tylerclindsay/volu_disp/docs/generators.md

# Generators

Status: **working draft.** Design of `volu_gen/generators/`, replacing open
question 1 in `architecture.md`. Values marked *(tune)* are starting
points to check by eye once methods exist; questions still open are
collected at the end.

Related: `architecture.md` (render job, storage), `ui.md` (Studio),
`decisions/0004-audio-analysis.md` (`analysis.json`),
`decisions/0010-display-fps.md`, `decisions/0011-planning-in-server.md`.

---

## Concept
The generator is a **director** that runs a set of **methods**. A method
is one way of animating the display from the music: rain, fireworks,
geometry, a 3D spectrogram, and so on. The director splits the track into
**segments** and picks a method (and that method's parameters) for each,
based on what the analysis knows about that part of the song. Calm parts
change rarely; high-energy parts change faster, per few bars or per bar.

Rendering is two steps:
1. **Plan.** The director reads the music data and writes a **plan**: a
   list of segments, each with a time range, a method, the method's
   params, and how it transitions in. The plan is plain data (JSON).
2. **Render.** Each segment's method renders its frames; the job blends
   transitions, applies intensity, quantizes, and writes the animation file.

```mermaid
flowchart LR
    AJ["analysis.json"]
    FT["features.npz"]
    AU["source + stems<br/>(samples)"]
    M["Music<br/>(queries over time)"]
    DP["track params<br/>(Studio)"]
    OV["instance edits<br/>(Studio, pinned)"]
    DIR["Director"]
    PLAN["Plan<br/>segments · methods · params"]
    METH["Methods"]
    OUT["blend transitions →<br/>intensity → uint8"]
    ANIM[".anim"]

    AJ --> M
    FT --> M
    AU --> M
    M --> DIR
    DP --> DIR
    OV --> DIR
    DIR --> PLAN
    PLAN --> METH
    M --> METH
    METH --> OUT --> ANIM
```

Splitting plan from render is what makes editing possible. In v1 the user
edits the params of each **instance** of a method (each segment it runs
in) in Studio; the future manual editor also changes which method runs on
which beats, bars, or sections. Either way the edits are plan entries the
director keeps, so it never has to understand them.

## Methods
Each method declares what it suits (phrase types, energy range) so the
director can choose it, and **chooses its own base params** from the
segment it's given (BPM, energy, mood, phrase type). Kicks and bass should
drive most of them visibly.

| Method | Idea | Driven by (examples) |
|---|---|---|
| `spectrogram` | 3D spectrogram: frequency across x, amplitude as height, history scrolling back through the slices (z) | band spectrum; kick → flash of the newest slice |
| `raindrops` | A "sea" surface of pixels at some height; drops land and spread ripples | hats spawn drops; kick → big drop; bass → swell height |
| `rain` | Falling streaks | density from energy; kick → gust or flash |
| `fireworks` | Launches, bursts into expanding shells that fall under gravity | accents (phrases, bars) launch; kick → burst; drops → volley |
| `strobe` | Full display or alternating slices, on beats or subdivisions | beat grid; drops only by default (see Smoothness) |
| `static` | TV-style noise, colorful or black and white | bass → density / brightness |
| `geometry` | Basic shapes (cube, sphere, torus, …) spinning smoothly and moving around | kick → scale pulse; bass → glow |
| `galaxy` | Individual pixels as stars; slow rotation, spiral arms, twinkle | energy → rotation speed; kick → brightening |
| `landscape` | Procedural mountain range scrolling through the display, as if flying over land | energy → speed; bass → terrain pulse |
| `supernova` | Spinning explosion from the center, expanding shell and debris | drop → explosion; kick → shockwaves |
| `oscilloscope` | A stem's waveform drawn as a line. 2D: in one slice, or copied to every slice. 3D: each slice holds an older frame's waveform, so the waveform scrolls back through the volume as a surface. Variant: one stem per group of slices | samples of a chosen stem; kick → line brightness / thickness |
| `vectorscope` | Stereo shapes: left vs. right channel as x / y (rotated 45° to mid/side, as a goniometer does), with a trail receding through the slices. 3D variant: delay embedding, `(s(t), s(t−τ), s(t−2τ))`, gives Lissajous-like 3D shapes even from mono stems | samples of a chosen stem; stereo width → shape size; kick → flash |
| `model` *(deferred)* | Plays a hand-made 3D animation file, set manually | needs an import format (e.g. glTF) and voxelization |

Interface:

```python
class Method(Protocol):
    id: ClassVar[str]                     # stable, e.g. "raindrops"
    version: ClassVar[int]                # bump when output changes for the same params
    Params: ClassVar[type[BaseModel]]     # per instance (segment); pydantic → JSON Schema
    suits: ClassVar[Suitability]          # phrase types, energy range, shortest segment (bars)

    @classmethod
    def choose_params(cls, seg: SegmentInfo, music: Music, rng) -> Params: ...

    def __init__(self, ctx: RenderContext, seg: SegmentInfo, params: Params): ...
    def render(self, start: int, stop: int) -> np.ndarray: ...   # float32 [n, P, 3]
```

- `render` works on **any frame range within the segment** (a little
  beyond it too, for transitions), vectorized over frames and pixels.
- `__init__` may precompute **cheap per-segment data**: particle spawn
  lists (time, position, size), the landscape's travelled distance (the
  integral of its speed over time), a star field. Each frame is then a
  closed-form function of time and that data, e.g. a ripple's radius is
  a function of time since its drop landed.
- No state carried frame to frame. This keeps segments independent: a
  transition can render two methods over the same frames, the manual
  editor can re-render one segment, and the deferred loop preview works.
  It rules out true simulations (fluids, reaction-diffusion); none of the
  methods above need one.
- Methods that read audio samples read only the requested range plus a
  declared look-back (e.g. the 3D oscilloscope's slice history), so they
  stay range-independent too.

**Waveform methods and smoothness.** Raw waveforms jitter and alias on a
sparse display, so `oscilloscope` and `vectorscope`:
- **trigger** like a real oscilloscope: align each frame's window to a
  rising zero crossing (or the pitch period), so a steady tone holds still
  instead of jumping between frames;
- **low-pass and resample** the window to the display's resolution before
  drawing (the prototype is 10 pixels wide: only ~10 points of waveform
  are visible), and draw the line with the usual soft falloff;
- **blend over a few frames** (short persistence, like phosphor), which
  also gives the vectorscope its trail.

Bass and kick stems are often near-mono, which collapses a left/right
vectorscope to a line; the director should prefer stems with stereo width
(a feature, below) or the delay-embedding variant.

**As built** (`methods/`, one module each, registered on import;
`decisions/0019-first-methods.md`). All four draw in `ctx.box` with soft
edges `ctx.pitch` wide, and share `methods/common.py`: `soft`,
`hit_env` (kick decays), `Signal.envelope` (a smoothed lane envelope over
the segment's span) and `Signal.integral` (speed → angle). Values are
starting points *(tune)*:
- `geometry` (class `Shapes`): `shapes` from sphere (shell), cube (edges),
  octahedron (shell), torus (tube) and rings (three at right angles). The
  shape turns `spin` times per bar about y plus a tumble axis, drifts on a
  Lissajous path (`wander`), pulses in scale on kicks (`pulse`, 0.12 s
  decay) and gets a bass halo (`glow`). With `swap_beats`, the next shape
  morphs in (the two distances blended) over `morph` beats, ending on the
  swap beat. Suits any phrase, −20 to +6 dB; drops get 2–3 shapes swapping
  every 1–2 beats, loud parts every 4 beats, quieter parts one shape.
- `raindrops`: a sea surface at `level`, raised by the bass (`swell`) and
  slow background waves, with dim water under it (`fill`). Drops land on a
  share of hats (`hats`), big drops on kicks of strength ≥ 0.5, and
  `ambient` drops per second at random times so calm parts still rain.
  The drop list is made once per segment; a drop falls under gravity for
  0.35 s, then a ring spreads at `speed` and fades (0.45 s), lifting and
  lighting the surface. Suits groove, breakdown and buildup, −30 to −2 dB,
  at least 2 bars.
- `strobe`: flashes `per_beat` times per beat from bar 1, `duty` of the
  period but at least one frame, halved until within `ctx.strobe_rate`.
  `pattern`: `all`, `slices` (odd and even slices take turns) or `chase`
  (one slice per flash, front to back). Color toward white by `white`;
  brightness follows the drums by `follow`. Suits drops only, −6 to +6 dB.
- `galaxy`: a disc tilted by `tilt` and `yaw` with `arms` logarithmic
  spiral arms (`twist`), a bulge and a core. The arms turn rigidly at a
  speed that follows the mix's energy (a third of `spin` when quiet).
  Each pixel is a star: a share (`stars`) bright, the rest dust, each
  twinkling at its own rate (`twinkle`). Kicks brighten it (`kick`, 0.25 s
  decay). Suits groove, breakdown and buildup, −40 to −4 dB, at least
  4 bars.

## Director
**Segmenting:**
- Start from the analysis phrases (8 bars from each section start and
  drop). Split further by energy: low energy keeps a method for a whole
  phrase or section; medium switches every 4 bars; high energy (drops)
  every 2 bars or every bar *(tune)*. Boundaries always land on the grid.
- **Per-beat changes happen inside a method**, not by switching methods
  (e.g. strobe alternating slices each beat, geometry swapping shapes on
  the beat). Per bar is the fastest the director switches methods.
- Variable-tempo tracks (no grid): segment by sections, use raw beats.

**Choosing a method** for a segment:
- Inputs: phrase type, energy (per-bar mix energy, drums/bass on or off),
  mood, genre, position in the track, and what came before.
- Each method's `suits` gives it a score for the segment; the director
  picks by weighted random choice with a per-segment seed, and avoids
  repeating the previous segment's method.
- **Repeated parts pick freely.** A second drop gets no special link to the
  first; it is scored and chosen like any other segment.
- A **track palette** is chosen once from mood and genre and passed to
  every method, so method changes stay visually coherent.

**Phrase types.** The director uses the analysis as it is: `drop`,
`buildup`, `breakdown` tags, untagged phrases (the track's "groove"),
drums/bass events, and per-bar energy. No intro/outro tags are added;
those parts already read as low energy, drums or bass off, at the start or
end of the track.

**Transitions.** Chosen from how different two neighboring segments really
are, not one fixed rule:
- **Into a drop: always a hard cut** on the downbeat.
- Otherwise the director scores the **contrast** between the two segments
  from these inputs (weights: open question 1): the energy jump (dB, per-bar mix energy), drums or
  bass switching on/off, a section boundary vs. a split inside a phrase,
  and a change of phrase tag.
- High contrast → a hard cut on the downbeat. Medium → a 1–2 beat
  crossfade (the baseline). Low (e.g. a split inside one phrase, same
  material) → a longer crossfade, up to a bar.
- The transition is part of each plan entry, so the editor can change it.

**As built** (`director.py`, `make_plan` / `replan`; constants marked
*(tune)* there):
- **Units:** phrase starts (variable tempo: section starts and drops),
  from bar 1 to one past the last downbeat. Each unit gets a **level**:
  `high` = a drop phrase; `low` = a breakdown (not also a buildup) or mean
  mix energy under −10 dB; else `medium`. `high` is drops only: most of an
  electronic track sits near its loud level (median bar ≈ −4 dB across the
  library), and switching every 2 bars through all of it was frantic.
- A unit under 2 bars (a section's short tail) joins the one before and
  takes its level; a short first unit joins the next; a drop never moves.
- **Segment length** per level at change rate 1: low 16 bars, medium 4,
  high 2 *(tune)*; divided by the change rate and rounded to a power of
  two, 1 to 64 bars. Consecutive units of one level in one section merge
  up to that length (so a calm intro and breakdown share one segment), and
  each run is cut into segments of it; a remainder of up to half a segment
  joins the last one. Never merged across a drop.
- **Score** = track-param weight × fit: 0 if the segment's tags miss the
  method's phrase types or it is shorter than `min_bars`, else
  `exp(−(d / 6 dB)²)` for the energy `d` outside its range. One uniform
  draw from the segment's plan RNG picks by weight, then the same RNG goes
  to `choose_params`. The previous segment's method scores 0 unless
  nothing else fits; if nothing fits at all, the weights alone choose.
  Mood, genre and position in the track don't enter the score yet.
- **Contrast** at a boundary bar: `|ΔdB| / 6` (mix, 2 bars either side,
  capped at 1) + 0.5 per drums/bass in/out within a bar (capped at 1) +
  0.5 for a section start or 0.25 for a phrase start + 0.5 if the tags
  change. ≥ 1 → cut; ≥ 0.5 → 1-beat crossfade; ≥ 0.25 → 2 beats; under →
  one bar. A crossfade is at most a quarter of either segment.
- **Pinned** segments (a previous plan's, passed to `make_plan`) are cut
  into the automatic segments, clipped to the track; pins outside it or
  of an unregistered method are dropped, override fields the method no
  longer has are dropped, and a bad override value fails planning. A
  pinned segment draws from its RNG like an automatic one, so pinning
  doesn't change its automatic params.
- **Palette:** named palettes in `palette.py`, each with three mood words;
  auto picks by weighted random choice (track seed, `TRACK_STREAM`), weight
  `exp(2 × mean z)` of its words. The server should pass library-wide mood
  z-scores (decision 0004); without them the track's own cosines are
  standardized across its words, which removes the track's overall level
  but not each word's bias. Genre isn't used yet. Plans store sRGB hex;
  `RenderContext.colors` gives methods linear RGB.

## Plan
```jsonc
{
  "director": { "version": 1, "params": { … } },        // track params
  "palette": [ … ],
  "segments": [
    { "start_bar": 1, "end_bar": 17, "start": 0.889, "end": 24.889,
      "method": "raindrops", "method_version": 1,
      "params": { "drop_size": 0.4, … },     // what choose_params picked
      "transition": { "kind": "cut" } },
    { "start_bar": 49, "end_bar": 57, …,
      "method": "raindrops",
      "params": { "drop_size": 0.4, … },
      "overrides": { "drop_size": 0.9 },     // user edit: this instance only
      "pinned": true,
      "transition": { "kind": "crossfade", "beats": 1 } }
  ]
}
```
- Deterministic: same analysis + features + track params + edits + seed +
  versions → same plan.
- **Instance edits** (v1): `overrides` holds only the fields the user
  changed; every other field stays automatic. A segment with overrides is
  **pinned**: re-planning (new track params or seed, a grid override, a
  generator or method version change) keeps its bars, method, and
  overrides, and plans the rest around it.
  Its automatic fields are re-chosen as usual.
- Segments are anchored by **bar numbers**, so they survive a grid
  override; `start`/`end` are recomputed from the current grid before
  every render, so a stored plan never renders on an old grid. Segments
  are contiguous; the first also covers any lead-in before its bar (it may
  start at bar 0) and the last runs to the end of the track.
- **Planning runs in the API server**, not as a worker job
  (`decisions/0011-planning-in-server.md`): it is pure Python over
  `analysis.json` and `features.npz` (milliseconds, no models), so Studio
  shows the new plan as soon as a track param or instance changes, without
  waiting behind analysis jobs. The render job is given the plan and
  renders exactly it. The version's DB row stores the track params and the
  plan; the `.anim` metadata carries a copy (`plan` key).
- Consequence: everything planning touches (the director, `Music`, each
  method's `Params` and `choose_params`) is imported by the server, so
  `generators/` keeps heavy imports (torch) out of module level.
- **Plans don't depend on the FPS.** Segments are in bars and seconds;
  the display FPS only enters at render time (including strobe's
  half-FPS limit, Smoothness), so an FPS re-render renders the stored
  plan unchanged (decision 0010). A render re-plans first only if the
  version has no plan yet or the generator or a method version changed;
  the new plan overwrites the stored one.
- **Manual editor (deferred):** also change a segment's method,
  boundaries, and transition; those edits pin the segment the same way.

## Studio parameters (v1)
Two levels:

**Track params** — the director's, constant for the whole track
(`DirectorParams`: `intensity`, `change_rate`, `palette`, `weights`,
`disabled`, `strobe_max_rate`, `seed`; intensity and the strobe rate don't
affect the plan and are applied at render):
- overall intensity / brightness
- change rate (how quickly segments switch, relative to the default)
- palette: from the track, or a user pick
- methods: which are enabled, and a weight for each (how often the
  director picks it)
- strobe max flash rate (default and ceiling: 60 flashes/s, or half the
  FPS if lower)
- seed (re-roll for a different plan)

**Instance params** — per use of a method. If `raindrops` runs in bars
1–17 and again in bars 49–57, each has its own drop size:
- Studio shows the plan as a **segment lane** above the stem lanes; each
  block is one instance, labeled with its method.
- Selecting a block opens that method's `Params` form, filled with the
  values `choose_params` picked. Changing a field overrides it for that
  instance only and pins the segment (Plan, above); changed fields are
  marked, and "reset" returns a field (or the whole instance) to
  automatic.
- The form is generated from the method's `Params` schema, so adding a
  param needs no UI code.

Presets save track params only. Instance edits belong to one track's plan
and are saved with its versions.

## Smoothness
Motion smoothness is a priority. The display is sparse (50 mm pitch), so
things must glide between pixels instead of popping:
- **Spatial:** never switch a pixel hard on/off at a shape's edge. Render
  every shape as a distance with a soft falloff about one pixel pitch
  wide, so a moving edge fades across pixels.
- **Temporal:** everything is a continuous function of time in seconds
  (not the frame index). Param changes ease in; envelopes have attack and
  release.
- **Hits:** a kick is a near-instant attack with a smooth decay
  (~100–300 ms): punchy without flicker.
- **Exceptions:** `static`, `strobe`, and star twinkle flicker on purpose.
  Strobe's max flash rate is **60 flashes/s**, or half the render's FPS
  if that is lower (one on/off cycle per two frames: 15 flashes/s at
  30 FPS, 60 from 120 FPS up); the track param can lower it. The plan
  holds the requested rate; the half-FPS limit is applied at render time,
  so the plan stays independent of the FPS. Faster
  flashing fuses into steady half brightness, so a strobe looks the same
  at any rate from 120 FPS up. A render always plays at its own FPS
  (decision 0010), so frames are never dropped and a strobe never
  aliases.

## Inputs
**`Music`** — built once per render from `analysis.json`,
`features.npz`, and the audio; vectorized queries over an array of times:
beat and bar index and phase, the current section and phrase and its tags,
time since and until events, per-bar energy (interpolated), feature
envelopes, genre, mood, palette. It hides grid vs. variable tempo and the
user override. The raw `analysis.json` dict is available as an escape
hatch. The API server also builds a `Music` for planning; it never
touches audio there (the server doesn't read audio), so audio is
decoded lazily, only when a method in the worker asks for samples.

**Audio samples** — methods can read the actual waveforms:
- `music.samples(stem, t0, t1)` → `[n, 2]` float32 stereo at 44.1 kHz,
  for `vocals`, `drums`, `bass`, `other` (`stems/*.flac`) or `mix`
  (`source.<ext>`).
- `music.windows(stem, ctx.times(start, stop), length)` →
  `[frames, length, 2]`: the window of samples ending at each frame's
  time, the common case for waveform methods (a frame spans
  ~1,470 / ~367 / ~92 samples at 30 / 120 / 480 FPS).
- Decoded once per render and cached in the render job: four stereo stems
  of a 4-min track are ~340 MB as float32, fine for the worker; decode per
  chunk if the large build makes this tight.
- Offline only: playback still reads just the animation file.

**`features.npz`** — needed from the start, since kicks and bass drive most
methods. A new CPU stage `features` in analysis (full spec in
`decisions/0012-stem-features.md`):
- onsets with strength: `kick` and `hat` only, recognized on the drums
  stem by a drum transcription model
  (`decisions/0016-drum-onsets-adtof.md`); the other drum classes and the
  `bass` / `other` / `vocals` onsets were not reliable and are not stored
  (`decisions/0017-kick-and-hat-onsets-only.md`)
- envelopes per lane (mix + four stems, RMS, 300 Hz), unsmoothed, with
  each lane's loud level so `Music` can normalize them
- a 24-band log-frequency spectrum (40 Hz – 16 kHz, 100 Hz) **per stem
  and for the mix**, for `spectrogram` and for coloring by what a stem is
  doing
- stereo width per lane (100 Hz), so the director can choose
  `vectorscope` and its stem
- fixed rates, independent of the display FPS and the grid, so neither an
  FPS change nor a grid override re-runs this stage; `Music` interpolates
  envelopes and spectra to frame times, and onsets are stored as times, so
  a hit shows from the first frame starting at or after it, at any rate
- Methods use features where they can (cheap, precomputed) and raw
  samples where they need the waveform's shape.

**`RenderContext`** — pixel positions, fps (the display FPS when the
render started: any whole number from 30 to 480), frame count, `Music`,
seed. Methods work in seconds, never assume a frame rate, and look the
same at any rate:
- `pos`: normalized, centered, **y up** (rain and fireworks fall, the
  landscape has a ground), divided by the largest half-extent so aspect
  ratio is kept: a method written for the prototype fits the large build
- `box`: the same positions with each axis stretched to [-1, 1] (y up),
  so a shape fills the volume whatever its aspect, and `pitch`, the
  nearest-neighbour spacing in it (soft edges are about this wide); the
  first methods draw in `box` (`decisions/0019-first-methods.md`)
- also `pos_mm` and integer `(ix, iy, iz)` per pixel plus slice parity, for
  methods that address slices or strips (alternating-slice strobe)
- `times(start, stop)`: each frame's start, `k / fps`. The engine shows
  frame `floor(t × fps)` (`architecture.md` → Engine), so frame k is on
  screen from that time; a hit inside a frame first shows on the next one
  (under one frame late: ≤ 8 ms at 120 FPS), a constant the A/V offset
  calibration absorbs.
- frame count `ceil(duration × fps)`.
- `strobe_rate`: the fastest a method may flash, flashes/s: the track's
  `strobe_max_rate`, at most 60 and half the FPS (Smoothness).

Built: `volu_gen/generators/` → `music.py`, `context.py`, `method.py`
(interface, `SegmentInfo`, `Suitability`, registry, `segment_rng`),
`plan.py` (pydantic plan model), `director.py`, `palette.py`,
`render.py` (the render job) and `methods/`; tests in
`tests/test_generators.py`, `tests/test_director.py`,
`tests/test_render.py` and `tests/test_methods.py`.

## Output and render job
- Methods return float32 linear RGB `[0, 1]`. The job blends transitions,
  scales by the track's intensity, clips, and quantizes to uint8 for the
  file. No gamma curve: the file holds WS2811 PWM values, which are
  linear in light like the methods' output
  (`decisions/0018-render-output.md`).
- Global brightness is applied at playback by the engine (adjustable
  live, like the sync offset). There is no power cap
  (`decisions/0020-brightness-no-power-cap.md`).
- The job renders in animation-file chunks (1 s: `fps` frames), in order, and
  checks for cancel between chunks. A chunk that straddles a segment
  boundary asks both methods for their part.
- Randomness: a per-segment RNG seeded from `(seed, segment start bar)`,
  so re-planning or editing one segment doesn't reshuffle the others.
  Planning (`choose_params`) and rendering (`Method.rng`) draw from
  separate streams of it (`segment_rng`).
- Versions (integers): the generator version covers the director; each plan entry
  records its method version. A render is stale if either changed (or the
  geometry hash or file format version; `architecture.md` → Lifecycle),
  and re-rendering it after a version change re-plans first.
- numpy on the CPU first; allow torch inside a method if a 20k-pixel render
  measures too slow. Methods are registered in a dict keyed by `id`.

**As built** (`render.py`; decision 0018):
- `render_context(geometry, music, fps, plan)` builds the context from the
  plan's seed, palette and strobe limit. `Renderer(ctx, plan)` retimes
  the plan on the current grid and refuses a stale one (`StalePlan`:
  another director version, a changed or unregistered method), and
  validates every segment's params and overrides, before rendering a
  frame. The server re-plans; the job renders exactly what it's given.
- **Crossfades are centered on the downbeat**: `beats × beat length`,
  half before and half after, smoothstep weights, each half at most half
  the segment on its side so fades never overlap. A segment's weight is
  `ramp(t, start, h_in) − ramp(t, end, h_out)`, so each frame's weights sum
  to 1; a cut is a step (a frame starting on the downbeat is the new
  segment's). Blended in linear light.
- Each segment's method renders only the frames where its weight is
  above 0. Rendering any frame range gives the same frames, so the chunk
  size never changes the output (tested at 1, 7, 97 and 500 frames).
- A method is built at its first frame and dropped after its last, so
  memory stays flat. Its `SegmentInfo` carries the plan's retimed
  `start`/`end` (the first segment from 0 s, covering the lead-in; the
  last to the end of the track).
- Method output must be float32 `(n, P, 3)` and finite; anything else fails
  the render, naming the method and frame range.
- `render_anim(path, ctx, plan, render_id, progress=, cancelled=)` writes
  the `.anim` (`.tmp`, renamed when done) in 1 s chunks with the metadata
  of decision 0008 (generator id `director`), calls `progress` and checks
  `cancelled` between chunks; a cancel raises `RenderCancelled` and leaves
  no file.
- Overhead of the job alone (blend, quantize, zstd) at 20k pixels: about
  80 ms per second of track at 120 FPS, 320 ms at 480 FPS (dev PC, one
  trivial method); methods will dominate.

## Build order
1. The `features` analysis stage.
2. `Music`, `RenderContext`, the director, the plan, and the render job.
   *Built:* `Music`, `RenderContext`, the method interface and
   registry, the plan model, the director, and the render job (the worker
   process runs it: `worker/`). The director's lengths,
   levels and contrast weights are tuned by eye once the first methods
   exist.
3. First methods: `geometry`, `raindrops`, `strobe`, `galaxy` (they cover
   calm through drop). *Built* (decision 0019); their looks and the
   director's constants are tuned by eye on the display next.
4. The rest of the methods (including `oscilloscope` and `vectorscope`);
   `model` last.

## Settled
- **Method interface** as above: `id`, integer `version`, pydantic
  `Params`, `suits`, `choose_params`, and range-independent `render`; no
  state carried frame to frame.
- **Segmenting** from the analysis phrases, split by energy (bar counts
  *(tune)*); per bar is the fastest method switch, per-beat changes happen
  inside a method; variable-tempo tracks segment by sections.
- **Method choice** by `suits` scores and weighted random choice with a
  per-segment seed, no immediate repeats, one palette per track.
- **Transition contrast inputs:** energy jump, drums/bass on/off, section
  boundary vs. split inside a phrase, phrase tag change (weights still
  open).
- Methods can read the stems' and mix's audio samples, not only features.
- Planning runs in the API server (decision 0011).
- Methods render at the display FPS (any whole number from 30 to 480,
  decision 0010) and must not assume a rate.
- Repeated parts (e.g. a second drop) pick freely, like any segment.
- Transitions depend on the contrast between neighboring segments, with a
  1–2 beat crossfade as the baseline; drops always cut hard.
- The Studio v1 form has track params, plus params per method instance
  (each segment a method runs in), edited from the segment lane.
- No intro/outro detection; the director uses the existing analysis.
- Strobe max flash rate: 60 flashes/s, or half the FPS if lower; the
  track param can only lower it.
- Build order as above.

## Open questions
1. **Contrast score weights** for transitions: tune by eye once the
   director and the first methods exist.
2. **Other transition kinds** (flash, a wipe through the slices) beyond cut
   and crossfade: add if crossfades look flat.
