tylerclindsay/volu_disp/pcb/volu-disp-node/volu-disp-node.kicad_pcb

## KiCad design pcb/volu-disp-node/volu-disp-node.kicad_pcb (2026-11-12)

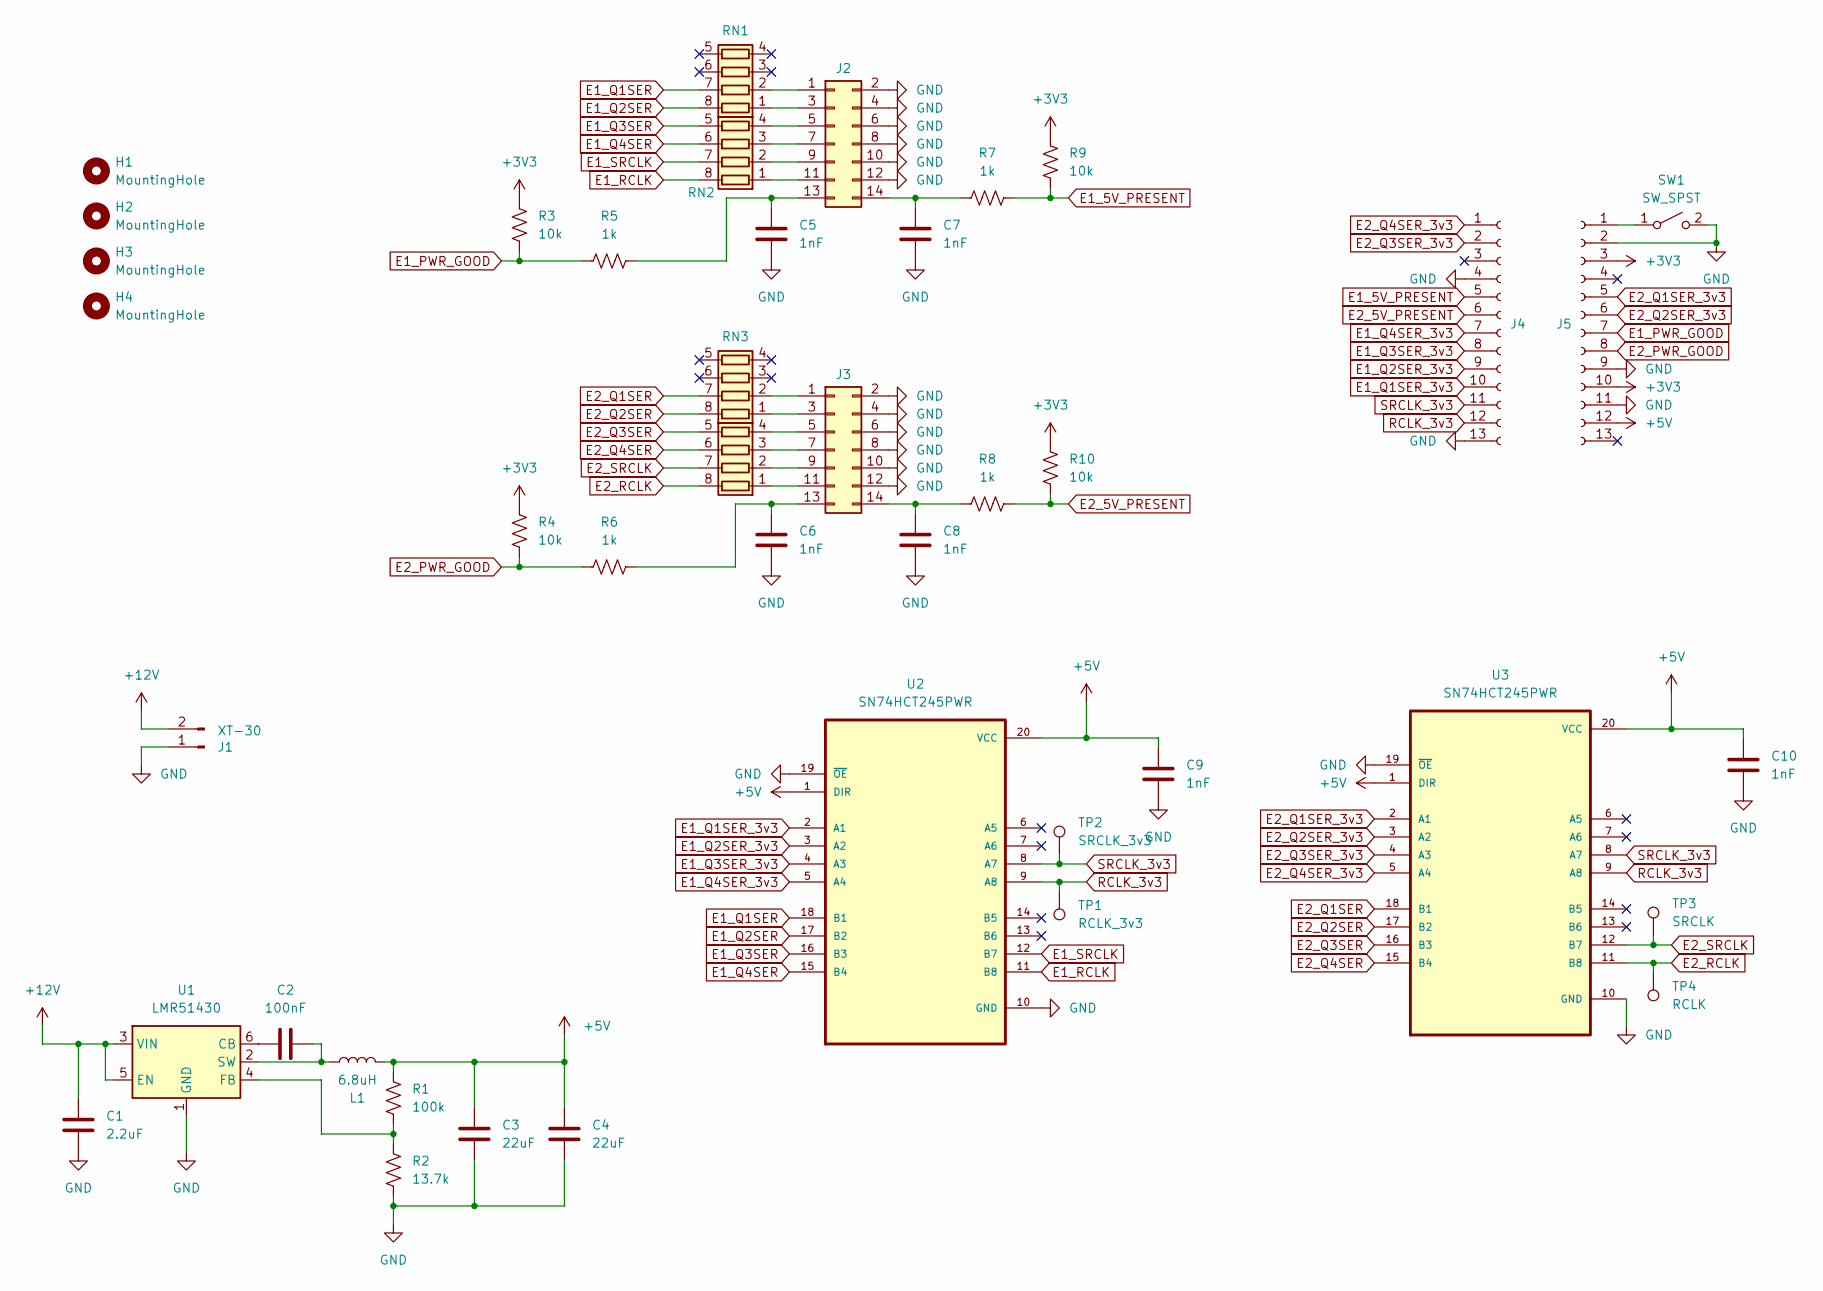
[picture p1: schematic volu-disp-node.kicad_sch]

Parts:
C1: 2.2uF; C_0603_1608Metric
C2: 100nF; C_0603_1608Metric
C3, C4: 22uF; C_0805_2012Metric
C5, C6, C7, C8, C9, C10: 1nF; C_0603_1608Metric
H1, H2, H3, H4: MountingHole; MountingHole_4.3mm_M4
J1: XT-30; AMASS_XT30PW-M_1x02_P2.50mm_Horizontal
J2, J3: Conn_02x07_Odd_Even; IDC-Header_2x07_P2.54mm_Latch_Vertical_SLIM
J4, J5: 01x13_Socket; PinSocket_1x13_P2.54mm_Vertical
L1: 6.8uH; L_7.3x7.3_H3.5
R1: 100k; R_0603_1608Metric
R2: 13.7k; R_0603_1608Metric
R3, R4, R9, R10: 10k; R_0603_1608Metric
R5, R6, R7, R8: 1k; R_0603_1608Metric
RN1, RN2, RN3, RN4: R_Pack04; R_Array_Convex_4x0603
SW1: SW_SPST; SW4_PTS815 SJM 250 SMTR LFS_CNK
TP1: RCLK_3v3; TestPoint_Pad_D2.0mm
TP2: SRCLK_3v3; TestPoint_Pad_D2.0mm
TP3: SRCLK; TestPoint_Pad_D2.0mm
TP4: RCLK; TestPoint_Pad_D2.0mm
U1: LMR51430; SOT-23-6
U2, U3: SN74HCT245PWR; SOP65P640X120-20N

Connections:
+3V3: J5.3, J5.10, R3.1, R4.1, R9.1, R10.1
+5V: C3.1, C4.1, C9.1, C10.1, J5.12, L1.2, R1.1, U2.1 (DIR), U2.20 (VCC), U3.1 (DIR), U3.20 (VCC)
+12V: C1.1, J1.2, U1.3 (VIN), U1.5 (EN)
E1_5V_PRESENT: J4.5, R7.2, R9.2
E1_PWR_GOOD: J5.7, R3.2, R5.1
E1_Q1SER: RN1.7 (R2.2), U2.18 (B1)
E1_Q1SER_3v3: J4.10, U2.2 (A1)
E1_Q2SER: RN1.8 (R1.2), U2.17 (B2)
E1_Q2SER_3v3: J4.9, U2.3 (A2)
E1_Q3SER: RN2.5 (R4.2), U2.16 (B3)
E1_Q3SER_3v3: J4.8, U2.4 (A3)
E1_Q4SER: RN2.6 (R3.2), U2.15 (B4)
E1_Q4SER_3v3: J4.7, U2.5 (A4)
E1_RCLK: RN2.8 (R1.2), U2.11 (B8)
E1_SRCLK: RN2.7 (R2.2), U2.12 (B7)
E2_5V_PRESENT: J4.6, R8.2, R10.2
E2_PWR_GOOD: J5.8, R4.2, R6.1
E2_Q1SER: RN3.7 (R2.2), U3.18 (B1)
E2_Q1SER_3v3: J5.5, U3.2 (A1)
E2_Q2SER: RN3.8 (R1.2), U3.17 (B2)
E2_Q2SER_3v3: J5.6, U3.3 (A2)
E2_Q3SER: RN4.5 (R4.2), U3.16 (B3)
E2_Q3SER_3v3: J4.2, U3.4 (A3)
E2_Q4SER: RN4.6 (R3.2), U3.15 (B4)
E2_Q4SER_3v3: J4.1, U3.5 (A4)
E2_RCLK: RN4.8 (R1.2), TP4.1, U3.11 (B8); also elsewhere on the board
E2_SRCLK: RN4.7 (R2.2), TP3.1, U3.12 (B7); also elsewhere on the board
GND: C1.2, C3.2, C4.2, C5.2, C6.2, C7.2, C8.2, C9.2, C10.2, J1.1, J2.2, J2.4, J2.6, J2.8, J2.10, J2.12, J3.2, J3.4, J3.6, J3.8, J3.10, J3.12, J4.4, J4.13, J5.2, J5.9, J5.11, R2.2, SW1.2 (B), U1.1 (GND), U2.10 (GND), U2.19 (~OE), U3.10 (GND), U3.19 (~OE)
unnamed: J2.1, RN1.2 (R2.1)
unnamed: J2.3, RN1.1 (R1.1)
unnamed: J2.5, RN2.4 (R4.1)
unnamed: J2.7, RN2.3 (R3.1)
unnamed: J2.9, RN2.2 (R2.1)
unnamed: J2.11, RN2.1 (R1.1)
unnamed: C5.1, J2.13, R5.2
unnamed: C7.1, J2.14, R7.1
unnamed: J3.1, RN3.2 (R2.1)
unnamed: J3.3, RN3.1 (R1.1)
unnamed: J3.5, RN4.4 (R4.1)
unnamed: J3.7, RN4.3 (R3.1)
unnamed: J3.9, RN4.2 (R2.1)
unnamed: J3.11, RN4.1 (R1.1)
unnamed: C6.1, J3.13, R6.2
unnamed: C8.1, J3.14, R8.1
unnamed: J5.1, SW1.1 (A)
unnamed: C2.1, U1.6 (CB)
unnamed: R1.2, R2.1, U1.4 (FB)
unnamed: C2.2, L1.1, U1.2 (SW)
RCLK_3v3: J4.12, TP1.1, U2.9 (A8), U3.9 (A8); also elsewhere on the board
SRCLK_3v3: J4.11, TP2.1, U2.8 (A7), U3.8 (A7); also elsewhere on the board

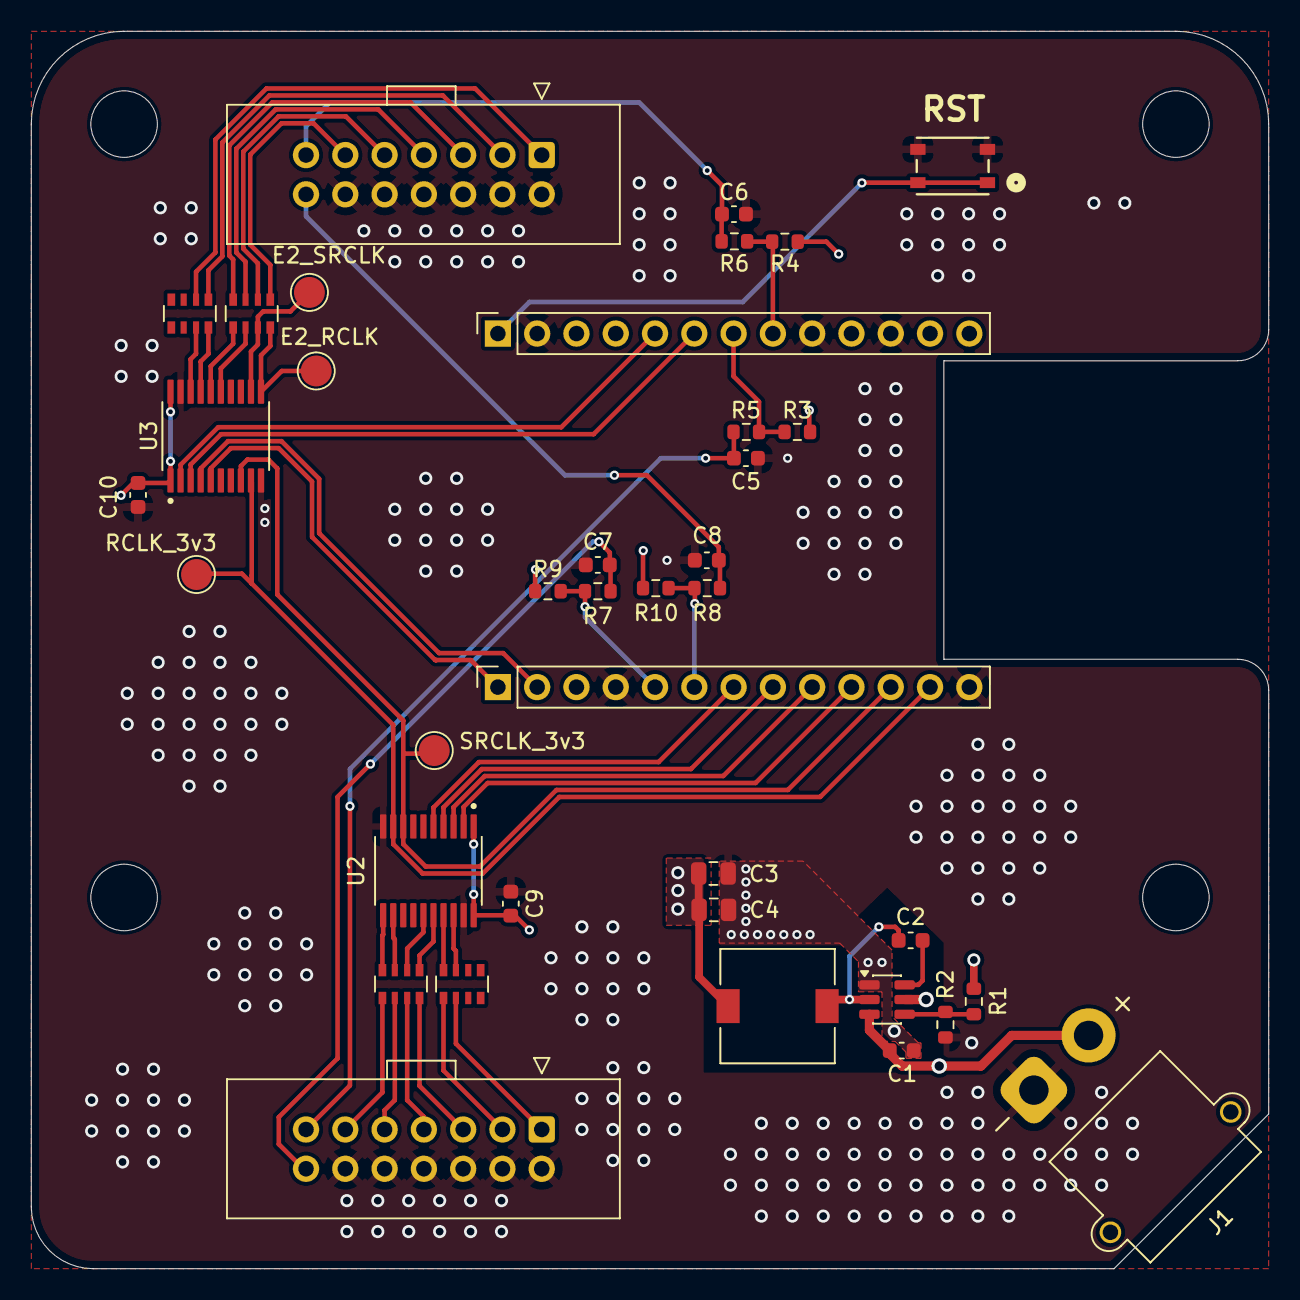
[picture p2: board volu-disp-node.kicad_pcb from above]

Board: 4 copper layers, 80.0 x 80.0 mm, 42 parts (0 on the bottom side), 50 nets.

Other parts of the board:
E2_RCLK: RCLK; TestPoint_Pad_D2.0mm
E2_SRCLK: SRCLK; TestPoint_Pad_D2.0mm
RCLK_3v3: RCLK_3v3; TestPoint_Pad_D2.0mm
SRCLK_3v3: SRCLK_3v3; TestPoint_Pad_D2.0mm

Their connections:
E2_RCLK: E2_RCLK.1; also elsewhere on the board
E2_SRCLK: E2_SRCLK.1; also elsewhere on the board
RCLK_3v3: RCLK_3v3.1; also elsewhere on the board
SRCLK_3v3: SRCLK_3v3.1; also elsewhere on the board
