tylerclindsay/volu_disp/pcb/volu-disp-node-edge/volu-disp-node-edge.kicad_pcb

## KiCad design pcb/volu-disp-node-edge/volu-disp-node-edge.kicad_pcb (2026-11-12)

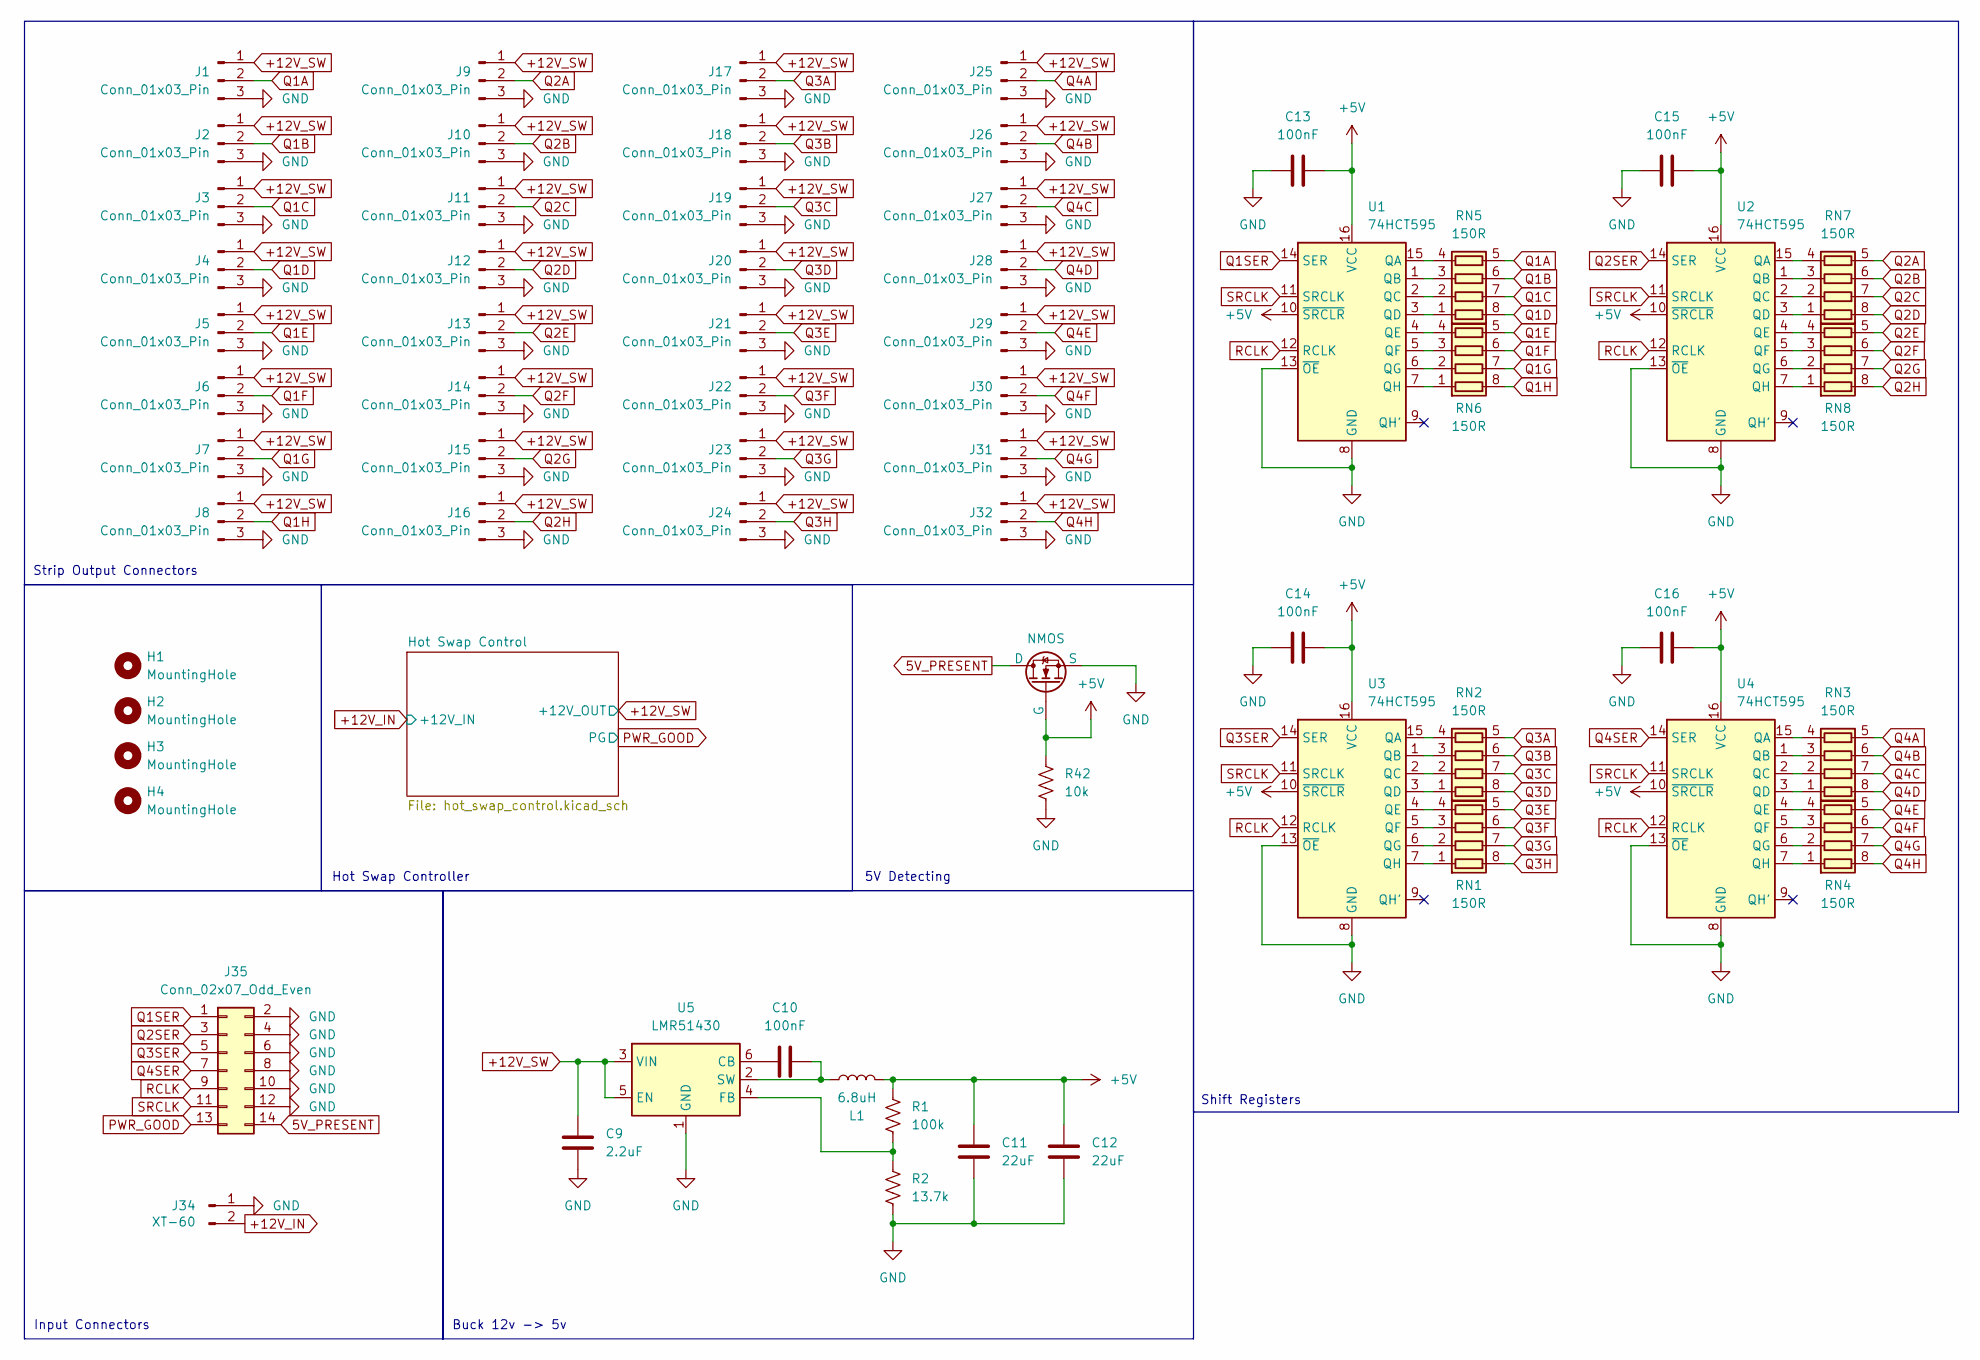
[picture p3: schematic volu-disp-node-edge.kicad_sch]

Parts:
C9: 2.2uF; C_0603_1608Metric
C10, C13, C14, C15, C16: 100nF; C_0603_1608Metric
C11, C12: 22uF; C_0805_2012Metric
H1, H2, H3, H4: MountingHole; MountingHole_4.3mm_M4
J1, J2, J3, J4, J5, J6, J7, J8, J9, J10, J11, J12, J13, J14, J15, J16, J17, J18, J19, J20, J21, J22, J23, J24, J25, J26, J27, J28, J29, J30, J31, J32: Conn_01x03_Pin; JST_XH_B3B-XH-A_1x03_P2.50mm_Vertical
J34: XT-60; AMASS_XT60PW-M_1x02_P7.20mm_Horizontal
J35: Conn_02x07_Odd_Even; IDC-Header_2x07_P2.54mm_Latch_Vertical
L1: 6.8uH; L_7.3x7.3_H3.5
Q2: NMOS; SOT-23
R1: 100k; R_0603_1608Metric
R2: 13.7k; R_0603_1608Metric
R42: 10k; R_0603_1608Metric
RN1, RN2, RN3, RN4, RN5, RN6, RN7, RN8: 150R; R_Array_Convex_4x0603
U1, U2, U3, U4: 74HCT595; SOIC-16_3.9x9.9mm_P1.27mm
U5: LMR51430; SOT-23-6

Connections:
5V_PRESENT: J35.14, Q2.3 (D)
+5V: C11.1, C12.1, C13.2, C14.2, C15.2, C16.2, L1.2, Q2.1 (G), R1.1, R42.1, U1.10 (~SRCLR), U1.16 (VCC), U2.10 (~SRCLR), U2.16 (VCC), U3.10 (~SRCLR), U3.16 (VCC), U4.10 (~SRCLR), U4.16 (VCC)
+12V_IN: J34.2; also elsewhere on the board
+12V_SW: C9.1, J1.1, J2.1, J3.1, J4.1, J5.1, J6.1, J7.1, J8.1, J9.1, J10.1, J11.1, J12.1, J13.1, J14.1, J15.1, J16.1, J17.1, J18.1, J19.1, J20.1, J21.1, J22.1, J23.1, J24.1, J25.1, J26.1, J27.1, J28.1, J29.1, J30.1, J31.1, J32.1, U5.3 (VIN), U5.5 (EN); also elsewhere on the board
GND: C9.2, C11.2, C12.2, C13.1, C14.1, C15.1, C16.1, J1.3, J2.3, J3.3, J4.3, J5.3, J6.3, J7.3, J8.3, J9.3, J10.3, J11.3, J12.3, J13.3, J14.3, J15.3, J16.3, J17.3, J18.3, J19.3, J20.3, J21.3, J22.3, J23.3, J24.3, J25.3, J26.3, J27.3, J28.3, J29.3, J30.3, J31.3, J32.3, J34.1, J35.2, J35.4, J35.6, J35.8, J35.10, J35.12, Q2.2 (S), R2.2, R42.2, U1.8 (GND), U1.13 (~OE), U2.8 (GND), U2.13 (~OE), U3.8 (GND), U3.13 (~OE), U4.8 (GND), U4.13 (~OE), U5.1 (GND); also elsewhere on the board
unnamed: RN1.1 (R1.1), U3.7 (QH)
unnamed: RN1.2 (R2.1), U3.6 (QG)
unnamed: RN1.3 (R3.1), U3.5 (QF)
unnamed: RN1.4 (R4.1), U3.4 (QE)
unnamed: RN2.1 (R1.1), U3.3 (QD)
unnamed: RN2.2 (R2.1), U3.2 (QC)
unnamed: RN2.3 (R3.1), U3.1 (QB)
unnamed: RN2.4 (R4.1), U3.15 (QA)
unnamed: RN3.1 (R1.1), U4.3 (QD)
unnamed: RN3.2 (R2.1), U4.2 (QC)
unnamed: RN3.3 (R3.1), U4.1 (QB)
unnamed: RN3.4 (R4.1), U4.15 (QA)
unnamed: RN4.1 (R1.1), U4.7 (QH)
unnamed: RN4.2 (R2.1), U4.6 (QG)
unnamed: RN4.3 (R3.1), U4.5 (QF)
unnamed: RN4.4 (R4.1), U4.4 (QE)
unnamed: RN5.1 (R1.1), U1.3 (QD)
unnamed: RN5.2 (R2.1), U1.2 (QC)
unnamed: RN5.3 (R3.1), U1.1 (QB)
unnamed: RN5.4 (R4.1), U1.15 (QA)
unnamed: RN6.1 (R1.1), U1.7 (QH)
unnamed: RN6.2 (R2.1), U1.6 (QG)
unnamed: RN6.3 (R3.1), U1.5 (QF)
unnamed: RN6.4 (R4.1), U1.4 (QE)
unnamed: RN7.1 (R1.1), U2.3 (QD)
unnamed: RN7.2 (R2.1), U2.2 (QC)
unnamed: RN7.3 (R3.1), U2.1 (QB)
unnamed: RN7.4 (R4.1), U2.15 (QA)
unnamed: RN8.1 (R1.1), U2.7 (QH)
unnamed: RN8.2 (R2.1), U2.6 (QG)
unnamed: RN8.3 (R3.1), U2.5 (QF)
unnamed: RN8.4 (R4.1), U2.4 (QE)
unnamed: C10.1, U5.6 (CB)
unnamed: R1.2, R2.1, U5.4 (FB)
unnamed: C10.2, L1.1, U5.2 (SW)
PWR_GOOD: J35.13; also elsewhere on the board
Q1A: J1.2, RN5.5 (R4.2)
Q1B: J2.2, RN5.6 (R3.2)
Q1C: J3.2, RN5.7 (R2.2)
Q1D: J4.2, RN5.8 (R1.2)
Q1E: J5.2, RN6.5 (R4.2)
Q1F: J6.2, RN6.6 (R3.2)
Q1G: J7.2, RN6.7 (R2.2)
Q1H: J8.2, RN6.8 (R1.2)
Q1SER: J35.1, U1.14 (SER)
Q2A: J9.2, RN7.5 (R4.2)
Q2B: J10.2, RN7.6 (R3.2)
Q2C: J11.2, RN7.7 (R2.2)
Q2D: J12.2, RN7.8 (R1.2)
Q2E: J13.2, RN8.5 (R4.2)
Q2F: J14.2, RN8.6 (R3.2)
Q2G: J15.2, RN8.7 (R2.2)
Q2H: J16.2, RN8.8 (R1.2)
Q2SER: J35.3, U2.14 (SER)
Q3A: J17.2, RN2.5 (R4.2)
Q3B: J18.2, RN2.6 (R3.2)
Q3C: J19.2, RN2.7 (R2.2)
Q3D: J20.2, RN2.8 (R1.2)
Q3E: J21.2, RN1.5 (R4.2)
Q3F: J22.2, RN1.6 (R3.2)
Q3G: J23.2, RN1.7 (R2.2)
Q3H: J24.2, RN1.8 (R1.2)
Q3SER: J35.5, U3.14 (SER)
Q4A: J25.2, RN3.5 (R4.2)
Q4B: J26.2, RN3.6 (R3.2)
Q4C: J27.2, RN3.7 (R2.2)
Q4D: J28.2, RN3.8 (R1.2)
Q4E: J29.2, RN4.5 (R4.2)
Q4F: J30.2, RN4.6 (R3.2)
Q4G: J31.2, RN4.7 (R2.2)
Q4H: J32.2, RN4.8 (R1.2)
Q4SER: J35.7, U4.14 (SER)
RCLK: J35.9, U1.12 (RCLK), U2.12 (RCLK), U3.12 (RCLK), U4.12 (RCLK)
SRCLK: J35.11, U1.11 (SRCLK), U2.11 (SRCLK), U3.11 (SRCLK), U4.11 (SRCLK)

Notes on the sheet:
Buck 12v -> 5v
Strip Output Connectors
5V Detecting
Hot Swap Controller
Input Connectors
Shift Registers

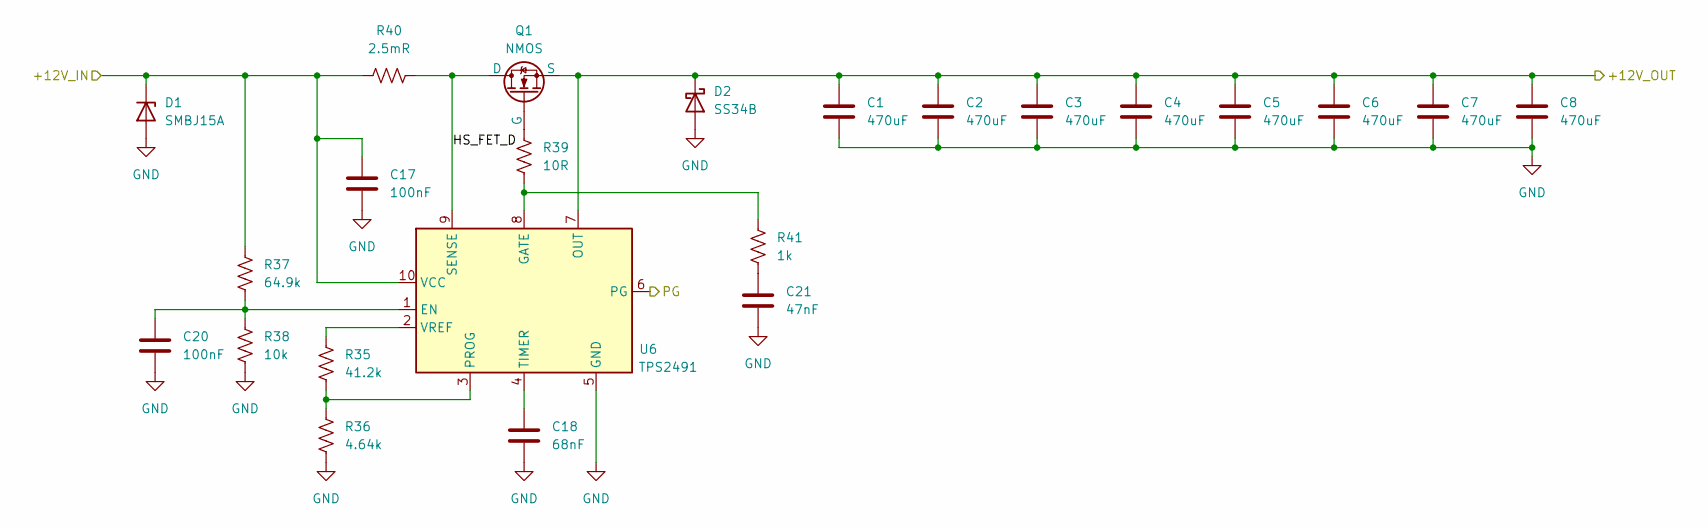
[picture p4: schematic hot_swap_control.kicad_sch]

Parts:
C1, C2, C3, C4, C5, C6, C7, C8: 470uF; CP_Radial_D10.0mm_P5.00mm
C17, C20: 100nF; C_0603_1608Metric
C18: 68nF; C_0603_1608Metric
C21: 47nF; C_0603_1608Metric
D1: SMBJ15A; D_SMB
D2: SS34B; D_SMB
Q1: NMOS; PQFN-8-EP_6x5mm_P1.27mm_Generic
R35: 41.2k; R_0603_1608Metric
R36: 4.64k; R_0603_1608Metric
R37: 64.9k; R_0603_1608Metric
R38: 10k; R_0603_1608Metric
R39: 10R; R_0603_1608Metric
R40: 2.5mR; R_2512_6332Metric
R41: 1k; R_0603_1608Metric
U6: TPS2491; VSSOP-10_3x3mm_P0.5mm

Connections:
+12V_IN: C17.1, D1.1 (K), R37.1, R40.1, U6.10 (VCC); also elsewhere on the board
+12V_SW: C1.1, C2.1, C3.1, C4.1, C5.1, C6.1, C7.1, C8.1, D2.1 (K), Q1.3 (S), U6.7 (OUT); also elsewhere on the board
/Hot Swap Control/HS_FET_D: Q1.1 (D), R40.2, U6.9 (SENSE)
GND: C1.2, C2.2, C3.2, C4.2, C5.2, C6.2, C7.2, C8.2, C17.2, C18.2, C20.2, C21.2, D1.2 (A), D2.2 (A), R36.2, R38.2, U6.5 (GND); also elsewhere on the board
unnamed: C21.1, R41.2
unnamed: Q1.2 (G), R39.1
unnamed: C20.1, R37.2, R38.1, U6.1 (EN)
unnamed: R39.2, R41.1, U6.8 (GATE)
unnamed: R35.2, R36.1, U6.3 (PROG)
unnamed: C18.1, U6.4 (TIMER)
unnamed: R35.1, U6.2 (VREF)
PWR_GOOD: U6.6 (PG); also elsewhere on the board

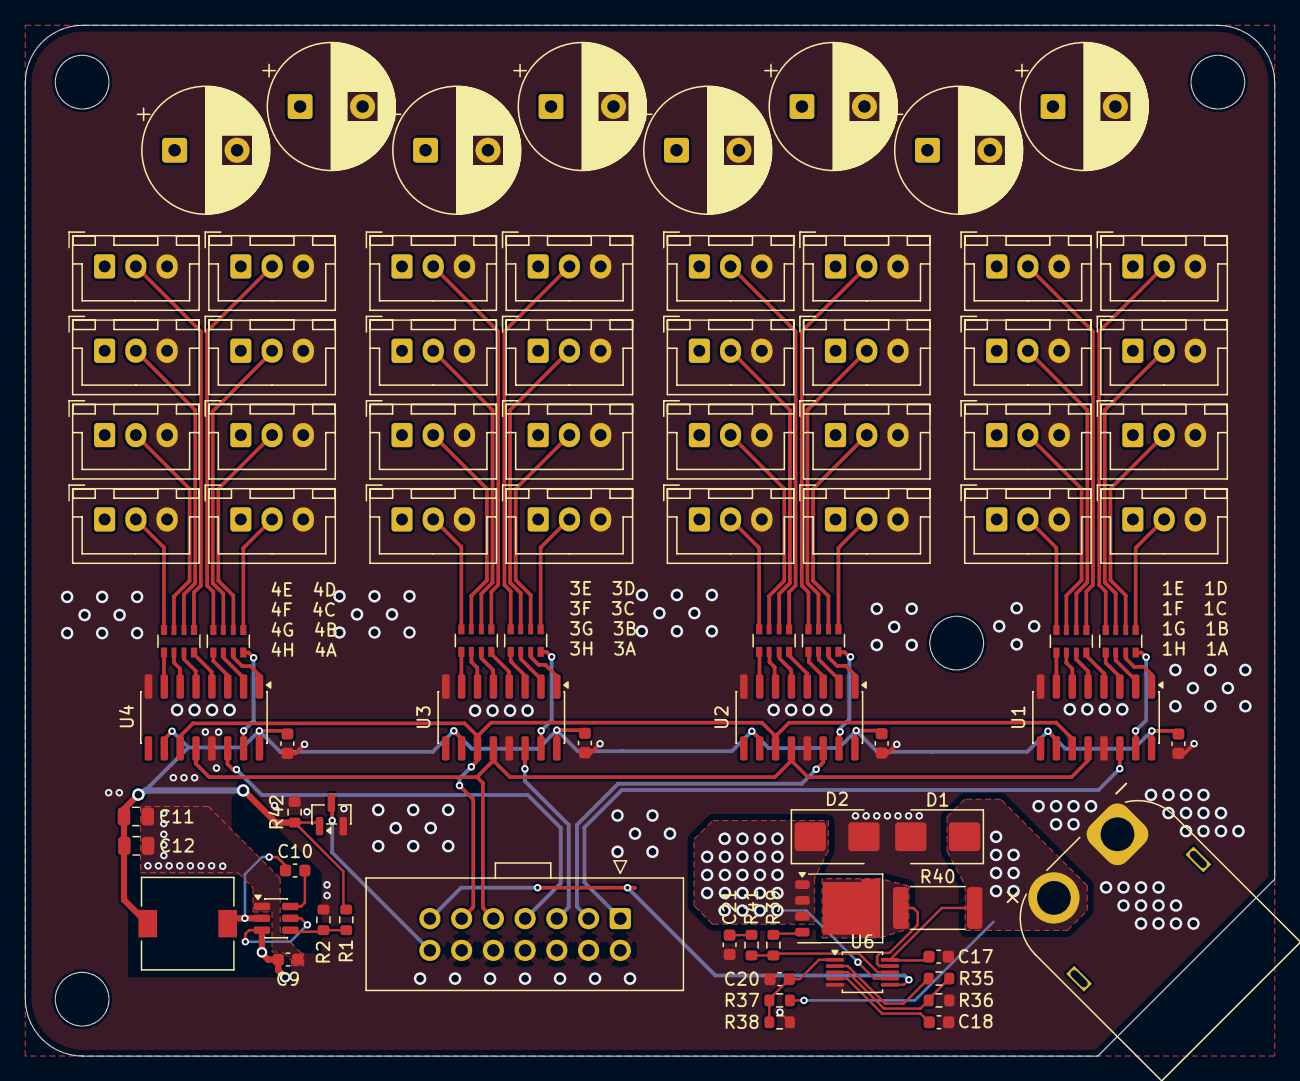
[picture p5: board volu-disp-node-edge.kicad_pcb from above]

Board: 4 copper layers, 100.0 x 82.5 mm, 87 parts (0 on the bottom side), 87 nets.
