tylerclindsay/volu_disp/pcb/volu-disp-strip-interface/volu-disp-strip-interface.kicad_pcb

## KiCad design pcb/volu-disp-strip-interface/volu-disp-strip-interface.kicad_pcb (2026-11-02)

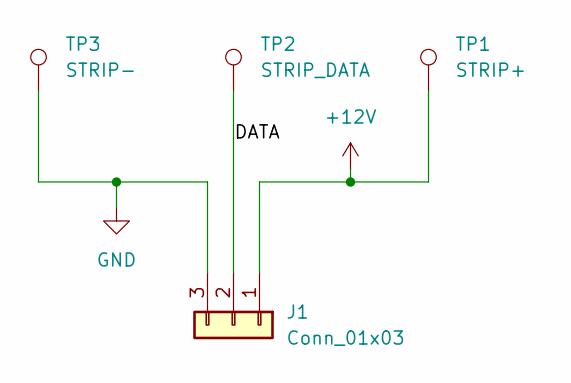
[picture p6: schematic volu-disp-strip-interface.kicad_sch]

Parts:
J1: Conn_01x03; JST_XH_B3B-XH-A_1x03_P2.50mm_Vertical
TP1: STRIP+; TestPoint_Pad_5.0x2mm_slim
TP2: STRIP_DATA; TestPoint_Pad_5.0x2mm_slim
TP3: STRIP-; TestPoint_Pad_5.0x2mm_slim

Connections:
+12V: J1.1, TP1.1
/DATA: J1.2, TP2.1
GND: J1.3, TP3.1

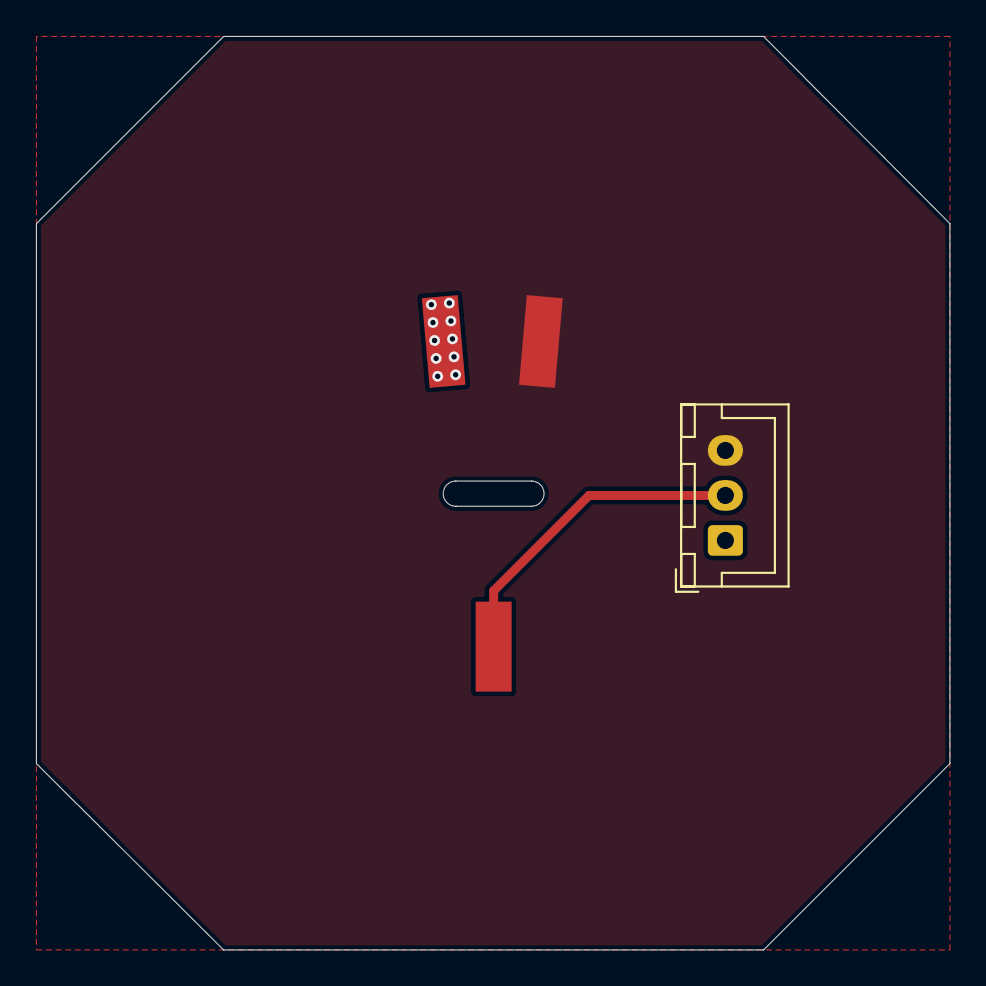
[picture p7: board volu-disp-strip-interface.kicad_pcb from above]

Board: 2 copper layers, 50.8 x 50.8 mm, 4 parts (0 on the bottom side), 3 nets.
