tylerclindsay/volu_disp/(commit log)

2026-10-09 edge nodes schematic WIP
2026-10-09 edge node schematic mostly done, need to add bulk caps still
2026-10-09 basic edge node schematic done, excludes fusing and soft-start
2026-10-11 assigned footprints
2026-10-15 edge node schematic done, pcb done. next is main node circuit and pcb
2026-11-02 Update edge node PCB, add main node and strip interface projects
    Edge node board/schematic updates with v1 gerbers; new volu-disp-node
    and volu-disp-strip-interface KiCad projects; refresh backup archives.
2026-11-02 Restructure repo: firmware/, tools/, docs/, config/, split AGENTS.md
    - volu_disp_edge/ -> firmware/drive_node/ (firmware runs on the drive node)
    - scripts/ -> tools/
    - Root AGENTS.md holds whole-system facts; gen_system/AGENTS.md holds
    host software guidance
    - Add docs/ (requirements, protocol, architecture stub, decision 0001)
    - Add config/displays/prototype.yaml draft and gitignored data/
2026-11-02 Add prototype geometry and per-drive-node section mapping
    - Slice spacing 25 mm; prototype 10 x 12 x 8 (80 strips, 960 pixels)
    - Each drive node owns a rectangular section of the display; prototype
    split across 2 nodes
    - Correct edge node 595 count (4, not 5)
2026-11-02 Confirm prototype node split and pixel 0 at top of strip
    Strip numbering within a node is recorded as the planned default.
2026-11-02 Specify wire protocol v2
    Versioned header with frame number, flat per-node pixel buffer addressing,
    broadcast SYNC latch, double buffering. Firmware and tools still on v1.
2026-11-02 Add UI design (v1) and stack decision
    docs/ui.md describes the pages (Library, Player, Studio, Display,
    Settings), the persistent transport/status bar, the play queue, the
    Studio full-track re-render loop, and auto-armed hardware output.
    Decision 0003 records the stack: Vite + React + TS, Mantine,
    react-three-fiber, TanStack Query + Zustand, TanStack Router.
2026-11-02 Add backend audio analysis package (volu_gen.analysis)
    Port of the analysis spike into gen_system/backend: stems, beat grid,
    sections, genre, mood, phrases, cache, and click-track checks, per
    decision 0004.
2026-11-02 Detect drops per bar (decision 0005)
    Drops are checked at every bar and start phrases. A new "low" lane
    (drums + bass below 150 Hz) replaces the bass-on check, a candidate
    before the level arrives moves to the arrival bar, and a jump a full
    phrase after a drop counts as a new drop. The level and drum-hold
    checks are commented out until checked on held-out tracks.
    analysis.json version 2 adds bars.energy_db.low.
2026-11-07 Add waveform peaks stage for UI stem lanes (decision 0006)
    CPU-only `peaks` stage: per-bucket min/max/rms of the mix and each stem on
    one linear int16 scale, 300 buckets/s with 9 halving levels, stored as
    peaks.npz in the track cache. Re-runs when stems are newer, the file is
    missing, or its version differs; analysis.json is unchanged.
2026-11-09 Add architecture draft; store per-track data in data/tracks
    docs/architecture.md is the working architecture for gen_system: three
    backend processes (API server, real-time engine, GPU worker), their IPC
    messages, main flows, failure handling, data layers, storage and package
    layout, and open questions. It overrides the "Recommended approach" in
    gen_system/AGENTS.md where they differ.
    Stems, analysis.json and peaks.npz are stored track data, not a cache:
    analysis.json holds the user's grid override, and the rest is costly to
    rebuild. Rename data/cache/ to data/tracks/ (one directory per track,
    animations included), analysis/cache.py to track.py, and TrackCache to
    TrackDir.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
2026-11-09 Copy source audio into the track dir on import
    Tracks no longer reference their audio in place. import_track reads the
    original once, hashing while copying it to tracks/<key>/source.<ext>;
    re-importing the same bytes returns the existing track without writing to
    it. Reasons: browser uploads have no path, tag edits on the original no
    longer change the key, tracks survive a missing source drive, and each
    track dir is self-contained.
    - analysis.json source block: path -> original_path, plus name; old
    track dirs are migrated on open. A schema reset keeps the source block.
    - CLI imports files/folders, accepts track dirs, adds --all.
    - Drop file_sha256 (unused) and the data/library folder conce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
2026-11-09 Settle architecture open questions; add A/V sync controls
    - Server restart keeps playback running; imports processed in series,
    one track at a time (drops yield/yielded); unrendered queued tracks
    are skipped.
    - UI preview targets 120 FPS via a preview FPS setting.
    - Animation file format: lossless/near-lossless chunked compression as
    the direction; audio output API proposal (WASAPI shared default).
    - Display offset is a live, per-device UI setting with a Sync popover;
    separate preview offset so the 3D preview stays aligned.
2026-11-09 Settle animation file format (decision 0008)
    Chunked single-file container: 1 s chunks, per-chunk temporal delta +
    zstd, chunk index at the end, decoded by an engine prefetch thread.
    Adds the synthetic codec benchmark behind the decision.
2026-11-09 Implement animfile module (decision 0008)
    AnimWriter streams frames into 1 s chunks, picks raw or temporal-delta
    per chunk, zstd-compresses with checksums, and writes .tmp then renames.
    AnimReader validates the container on open and each chunk on decode;
    chunk() is thread-safe for the engine's prefetch thread. Adds zstandard
    and tests, including a byte-exact container vector and corruption cases.
    Also adds a note to AGENTS.md: a bug worth documenting is worth fixing.
2026-11-10 Design generators: director, plan, methods; audio output decision
    - docs/generators.md: director picks a method per segment and writes a
    plan; methods render segments; per-instance params pinned across
    re-plans; methods can read stem audio samples.
    - Decision 0009: WASAPI shared by default, exclusive as a setting.
    - architecture, ui, requirements updated to match.
2026-11-10 Plan renders in the API server; make display FPS a 60/120/240 setting
    - Decision 0011: the server runs the director in-process on every edit,
    grid override, and render; the worker renders the plan it is given.
    The plan is stored in the version row and the .anim `plan` key.
    - Decision 0010: one display FPS setting (60, 120 default, 240) replaces
    max_fps and the playback FPS. Renders use it; lowering drops frames,
    raising flags lower-rate renders stale for re-render.
    - Replace fixed-120 assumptions across docs, AGENTS.md, and the
    prototype display config.
2026-11-10 Settle grid/plan, draft rows, restart, Studio mode, track boundaries
    - Segment times are recomputed from bars on the current grid before every
    render; a grid override marks versions stale without re-planning them.
    - One draft row per track; saving shares its file; active may be the draft;
    replacing a loaded file sends swap_anim.
    - Server startup adopts a running engine and kills a surviving worker
    before spawning; *.tmp cleanup waits for it. hello carries the PID.
    - Studio mode as Main flow 7: leaving returns the queue paused; Studio
    keeps no playhead per track.
    - Queueing a track still being imported promotes its import work.
    - One output sample counter across tracks; frames come fr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
2026-11-10 Settle brightness/power cap, track removal, and stem features
    Drop the (proposed) markers in architecture.md and generators.md, list
    the three under Settled, and mark decision 0012 accepted.
2026-11-10 Move hardware facts to docs/hardware.md; slim root AGENTS.md
    Terminology, hardware, geometry, mapping, and open hardware questions
    move to docs/hardware.md; the root AGENTS.md keeps key facts and links.
    Fix the data/ description and list all docs. gen_system/AGENTS.md: link
    architecture, generators, and ui docs; add a generators section and the
    features stage; add the FPS strip check to mapping validation; update
    generator testing priorities. Note the move in decision 0001.
2026-11-10 Add output: protocol v2, packetizer, sender, fake nodes
    volu_gen.output holds the v2 constants and byte layout, a packetizer that
    fills packets fully from preallocated per-node buffers, a UDP sender
    (PIXELS per node, then one SYNC; its own u32 frame counter), and NodeSim,
    the node receive rules. tools/fake_node.py runs NodeSims on UDP;
    python -m volu_gen.output sends test patterns to fake or real nodes.
2026-11-10 Drive node firmware: protocol v2, edge node output, modules
    The firmware now speaks protocol v2 (frame numbers, flat per-node buffer,
    SYNC latch, double buffering) and drives the edge nodes' 74HCT595s over
    I2S1 parallel DMA with its own driver (decision 0014), replacing FastLED.
    5V_PRESENT gates each edge node's data lines; PWR_GOOD (active low, pulled
    up on the drive node) is reported. Logs and stats go as UDP text to port
    7778 once UART0's pins carry LED data (tools/node_stats.py).
    Split into modules (decision 0015): receiver, frames, edge_power, stats,
    log; main.cpp keeps only setup order and the loop schedule. edge_out.cpp's
    large functions are split, with the DMA interrupt path kept in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
2026-11-10 Bench config: 40 x 12, matching the drive node firmware defaults
    bench.yaml described a 2 x 10 bench while the firmware defaults are
    40 x 12, so every frame counted as incomplete on the node. The bench is
    now one node laid out as prototype.yaml's node 1. Update the config.h
    comment, docs/hardware.md, and udp_rainbow_sender.py defaults to match.
    Also refresh the volu-disp-node KiCad backup.
2026-11-10 docs/hardware.md: drive node GPIO assignment tables
    Replace the one-paragraph pin list with tables for the LED outputs (GPIO,
    net, edge node, strips, connectors) and the edge power inputs, list the
    WT32's internal Ethernet pins, and note the gotchas: UART0 on IO1/IO3,
    floating input-only pins on a bare module, and strapping pins in use.
2026-11-10 Analysis: stem features stage, drum onsets from ADTOF New CPU stage `features` (decision 0012) writes features.npz per track: per-lane RMS envelopes (300 Hz), 24-band spectra and stereo width (100 Hz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
    Drum onsets (kick, snare, tom, hat, cymbal) come from the ADTOF drum
    transcription model on the demucs drums stem, each hit snapped to the
    attack in the stem (decision 0016). The first version's frequency-band
    classes failed by ear: several clicks per kick and snares counted as
    kicks. drumsep separation split EDM kicks into tom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
2026-11-10 Generators: Music, RenderContext, method interface, plan model
    First piece of volu_gen.generators (docs/generators.md, build order 2).
    Music wraps analysis.json, features.npz and lazily decoded audio as
    vectorized queries over time: bar/beat position and phase, sections,
    phrases, per-bar energy, envelopes, spectra, width, kick/hat onsets with
    since/until, and sample windows. RenderContext holds normalized y-up
    positions, slice parity, fps and frame times (frame k at k / fps). The
    Method base class, SegmentInfo, Suitability, a validated registry and
    per-segment RNG streams define the method interface; the plan is a
    pydantic model that checks contiguity and retimes segments from bars.
    No torch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
2026-11-10 Generators: the director
    make_plan / replan turn a track's Music and track params (DirectorParams)
    into a plan: segments from phrase starts (variable tempo: sections and
    drops), split by level (drop 2 bars, medium 4, calm up to 16 at change
    rate 1); a method per segment by suits x weight with no immediate
    repeats; transitions from a contrast score, always a cut into a drop;
    pinned segments kept and planned around. Track palettes chosen from mood
    (palette.py); RenderContext.colors gives methods linear RGB.
2026-11-10 Generators: the render job (decision 0018)
    render.py renders a plan into an .anim: retimes it on the current grid,
    refuses a stale plan (StalePlan), blends crossfades centered on the
    downbeat in linear light, scales by intensity and quantizes to linear PWM
    values with no gamma curve. Renders in 1 s chunks with progress and
    cancel; any frame range gives the same frames. RenderContext gains the
    strobe limit (strobe_rate).
2026-11-10 Generators: first methods (geometry, raindrops, strobe, galaxy)
    Four registered methods in generators/methods/, chosen by the director
    from calm to drop:
    - geometry: shapes spinning and drifting, kick scale pulse, bass glow,
    morphing to the next shape on the beat
    - raindrops: a bass-swelled sea; drops land on hats and strong kicks and
    spread ripples
    - strobe: beat-grid flashes (all, alternating slices, slice chase), at
    least one frame each, halved to stay under the strobe rate
    - galaxy: tilted spiral disc turning with the mix's energy, pixels as
    twinkling stars, kicks brighten
    Methods draw in RenderContext.box (each axis stretched to [-1, 1]) with
    soft edges ctx.pitch wide, and shar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
2026-11-11 UI: fill spec gaps; brightness only, no power cap (decision 0020)
    ui.md: track removal, failed statuses, empty and first-run states,
    Studio lane zoom/scroll, browser-side undo/redo with full-state steps,
    an Errors section, brightness control, display config chosen at server
    start. architecture.md: full-state plan requests, failed-job retry,
    `volu serve --display`. Power cap dropped everywhere (no current
    sensing; a per-pixel estimate is too rough to trust).
2026-11-11 fix disconnected ground planes issue in edge board
2026-11-11 fix GPIO pin assignments for edge node outputs and power status
2026-11-11 Server: DB, settings, library, planning, versions, queues
    First increment of the API server (volu_gen/server), everything that
    needs no worker or engine yet:
    - `volu serve --display <config>`: FastAPI under /api, port 8770
    - SQLite (data/volu.db) with numbered migrations: tracks, versions,
    presets, settings, play queue, job queue
    - settings with the display FPS checked against the longest strip, and
    sync offsets per audio device + mode
    - import (upload, folder scan) queuing analyze; removal; orphaned dirs
    - analysis, binary peaks levels and pixel positions for the UI
    - planning from the full Studio state, versions, presets, render and
    re-render job rows, FPS-change and play-queue job p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
2026-11-11 IPC messages and sockets, and the worker process
    ipc/ (decision 0007):
    - messages.py: every server/engine/worker message as pydantic models,
    MessagePack-encoded, one union per direction; typed job specs and
    results; preview frames as a 16-byte header plus raw RGB
    - sockets.py: ROUTER/DEALER and PUB/SUB factories, default ports
    8771-8773, heartbeats, fixed server routing id, PeerWatch
    worker/:
    - jobs.py: analyze, regrid and render jobs (no DB, no IPC); renders
    refuse another geometry hash or output path
    - worker.py: one job at a time in a thread; latest-only progress;
    render cancel between chunks; a result the server missed is resent
    before the next hello reply; exits when the se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
2026-11-11 Server, IPC and worker: close gaps against the docs
    - progress is at most one per 50 ms by time, not one per poll loop (the
    loop wakes on every incoming message); a result drops its job's
    waiting progress
    ipc/:
    - paths in messages must be relative to the data dir (RelPath rejects
    absolute paths, drive paths and ".."); an absolute path would replace
    the data dir in `data_dir / path`
    server/:
    - jobs.next_job: priority, then a default render ahead of the rest of
    its priority, then FIFO (architecture.md → Worker → Priority)
    - fps-impact gives queue_rerender_seconds, estimated from recent render
    times (null before the first render)
    - 422s for a bad grid BPM and an unkno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
2026-11-11 Server: job dispatch, engine link, player, supervision, WebSocket
    The server now runs its children (everything but the engine itself):
    - core.py: Server (moved out of app.py) and Runtime (ports, spawn,
    ping). Startup: re-queue jobs left running, kill a surviving worker,
    delete leftover *.tmp, start the worker, adopt an engine that answers
    hello within 1 s or start one, pings, sweep, dispatch. A clean stop
    sends shutdown to the engine; a crash leaves it playing
    - dispatch.py: WorkerLink (hello, resubmit of a lost job, adoption of a
    running job in connect-only mode, cancel); build_spec re-plans a
    missing or stale plan and retimes it on the current grid; apply_result
    (analyze -> d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
2026-11-11 Server: fix method staleness, queue promotion, removal and FPS-change gaps
    - Method staleness comes from the method versions a file was rendered
    with (new render result field and versions column, migration 2 fills
    it from the plans of rendered rows), not from the row's plan, which a
    Studio edit or a failed/cancelled re-render can make newer than the file.
    - Queueing a track while its analyze runs promotes the running job too,
    so its default render gets play-queue priority.
    - Track removal returns 409 while the engine holds the track in either
    slot or has not released one of its animation files, so "delete data"
    never runs on files the engine has open.
    - A display FPS change puts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
2026-11-12 fix 74HCT245 wiring on drive node, GND plane gaps on edge node
